bindebende/PowerUART/README.md

# PowerUART
Under Development!!!
USB to UART converter with Type C connector and 100W Power Delivery

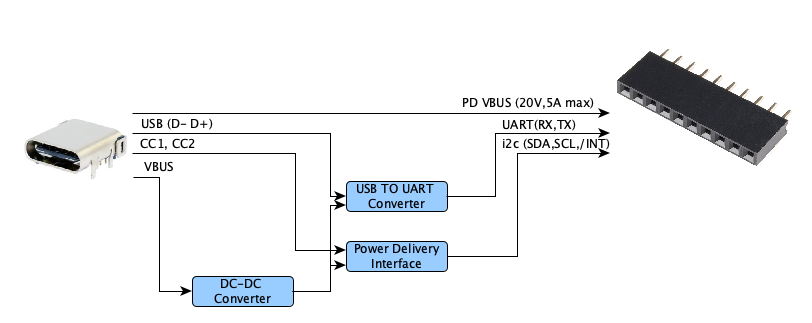
[picture p1: Design/HLD.png]
High Level Design
