bindebende/PowerUART/Design/source/BOM.xlsx

Function | Links | Price( min 100 pcs) | Extended price
PD interface | FUSB302BMPX (https://hu.mouser.com/ProductDetail/ON-Semiconductor-Fairchild/FUSB302BMPX) | 308.36 Ft | 30836.00 Ft
usb interface | CP2102N (https://hu.mouser.com/ProductDetail/Silicon-Labs/CP2102N-A01-GQFN24) | 402.21 Ft | 40221.00 Ft
usb con | usb type c con. Female (https://hu.mouser.com/ProductDetail/Amphenol-Commercial-Products/12401598E42A) | 389.31 Ft | 38931.00 Ft
tvs | ESD TVS (https://hu.mouser.com/ProductDetail/STMicroelectronics/ESDCAN24-2BLY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) | 44.47 Ft | 13341.00 Ft
LED | LED (https://hu.mouser.com/ProductDetail/Wurth-Electronics/150080GS75000) | 40.22 Ft | 16088.00 Ft
Supply | TPS57160QDRCRQ1 (https://hu.mouser.com/ProductDetail/Texas-Instruments/TPS57160QDRCRQ1) | 850.20 Ft | 85020.00 Ft
Input capacitor 2.2uF | Input capacitor 2.2uF (https://hu.mouser.com/ProductDetail/KEMET/C1206C225K3REC7210) | 20.93 Ft | 2093.00 Ft
Input capacitor 100nF | Input Capacitor 100nF (https://hu.mouser.com/ProductDetail/Murata-Electronics/GCM155R71H104ME02D) | 8.18 Ft | 818.00 Ft
Inductor | Inductor (https://hu.mouser.com/ProductDetail/Bourns/SRN6045TA-100M) | 68.67 Ft | 6867.00 Ft
output Cap | Output capacitor (https://hu.mouser.com/ProductDetail/AVX/TCJA476M006R0070) | 103.66 Ft | 10366.00 Ft
Diode | Diode (https://hu.mouser.com/ProductDetail/Vishay-Semiconductors/B240A-E3-5AT) | 52.32 Ft | 5232.00 Ft
SS/TR Cap 0.01uF | SS/TR cap 0.01uF (https://hu.mouser.com/ProductDetail/Murata-Electronics/GCM155R71E103JA37D) | 5.56 Ft | 556.00 Ft
CLK 90.9k | CLK resistor 90.9k (https://hu.mouser.com/ProductDetail/Yageo/RC0402FR-0790K9L?qs=sGAEpiMZZMtlubZbdhIBIDGYITUTlqW8U2zx0aAOop8%3d) | 0.98 Ft | 98.00 Ft
COMP 6.8pF | COMP 6.8pF (https://hu.mouser.com/ProductDetail/Wurth-Electronics/885012005054) | 3.92 Ft | 392.00 Ft
Comp 2.7nF | COMP 2.7nF (https://hu.mouser.com/ProductDetail/Yageo/CC0402KRX7R8BB272) | 3.27 Ft | 327.00 Ft
COMP 76.8k | COMP 76.8k (https://hu.mouser.com/ProductDetail/Yageo/RC0402FR-0776K8L?qs=sGAEpiMZZMvdGkrng054t8AJgcdMkx7xWtIAm8qlIKw%3d) | 0.98 Ft | 98.00 Ft
FB 52.5K | FB 52.5k (https://hu.mouser.com/ProductDetail/Yageo/RC0402FR-0752K3L?qs=sGAEpiMZZMvdGkrng054t8AJgcdMkx7xvsgsl41vLTs%3d) | 0.98 Ft | 98.00 Ft
FB 10K | FB 10k (https://hu.mouser.com/ProductDetail/Yageo/RC0402FR-0710KL?qs=sGAEpiMZZMvdGkrng054txdMlaQGj9fiev8zvarNyCY%3d) | 0.98 Ft | 98.00 Ft
PCB (100*100, 3 design/ panel, 2layer, bilind via) |  | 348.77 Ft | 19624.00 Ft
VAT+shipping |  | 825.83 Ft | 82582.74 Ft
SUM (HUF) |  | 3479.80 Ft | 353686.74 Ft
SUM (USD) |  | 12.23 USD | 1242.86 USD
Recomended selling price(USD) |  | 35.00 USD | 3500.00 USD
Margin(USD) |  | 22.77 USD | 2257.14 USD
Margin(HUF) |  | 6476.68 Ft | 641963.82 Ft
