bindebende/PowerUART/HW/Schematic/Outputs/PowerUART_schematic.pdf

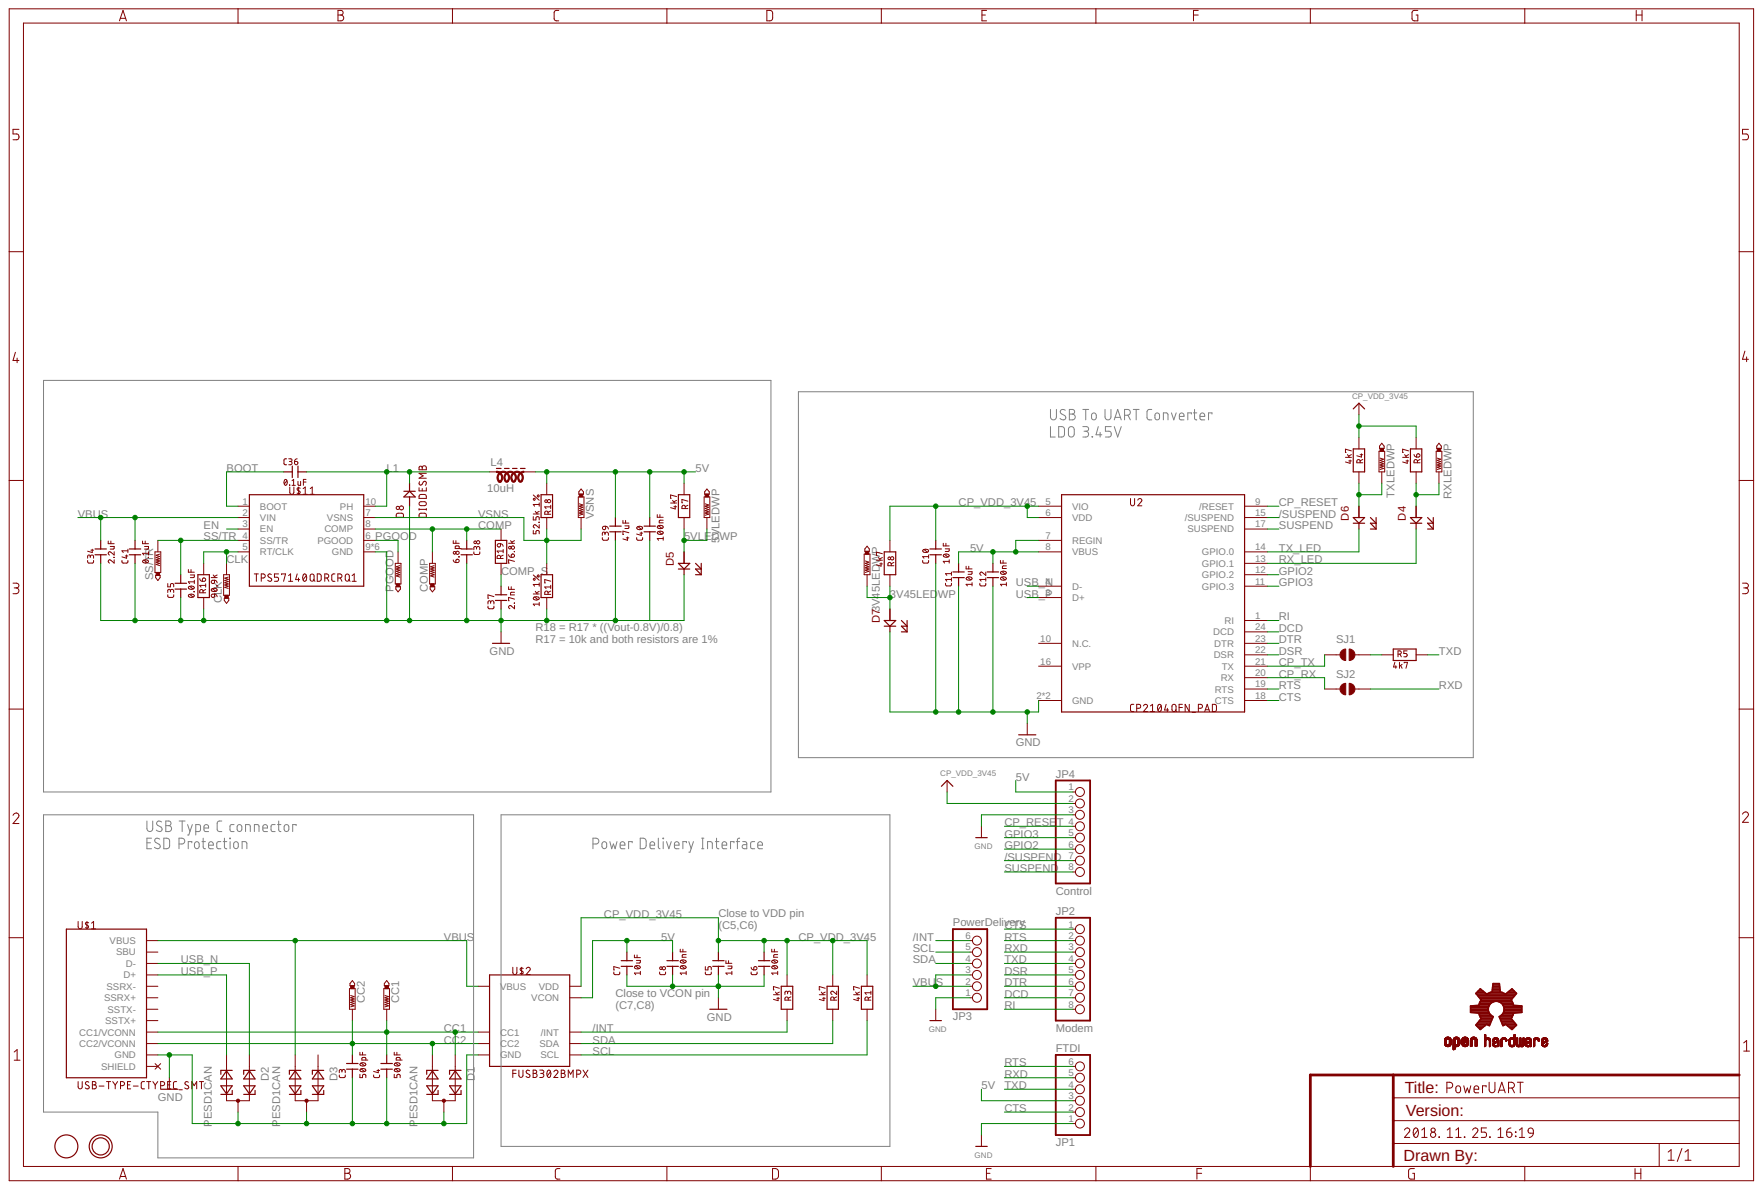
[picture p2: page 1]

D6 D4 Drawn By: Title: Version:

R18 = R17 * ((Vout-0.8V)/0.8) R17 = 10k and both resistors are 1%

CP_VDD_3V45
(C5,C6) Close to VCON pin
SCL SDA

Close to VDD pin
