bindebende/PowerUART/Design/HLD.pdf

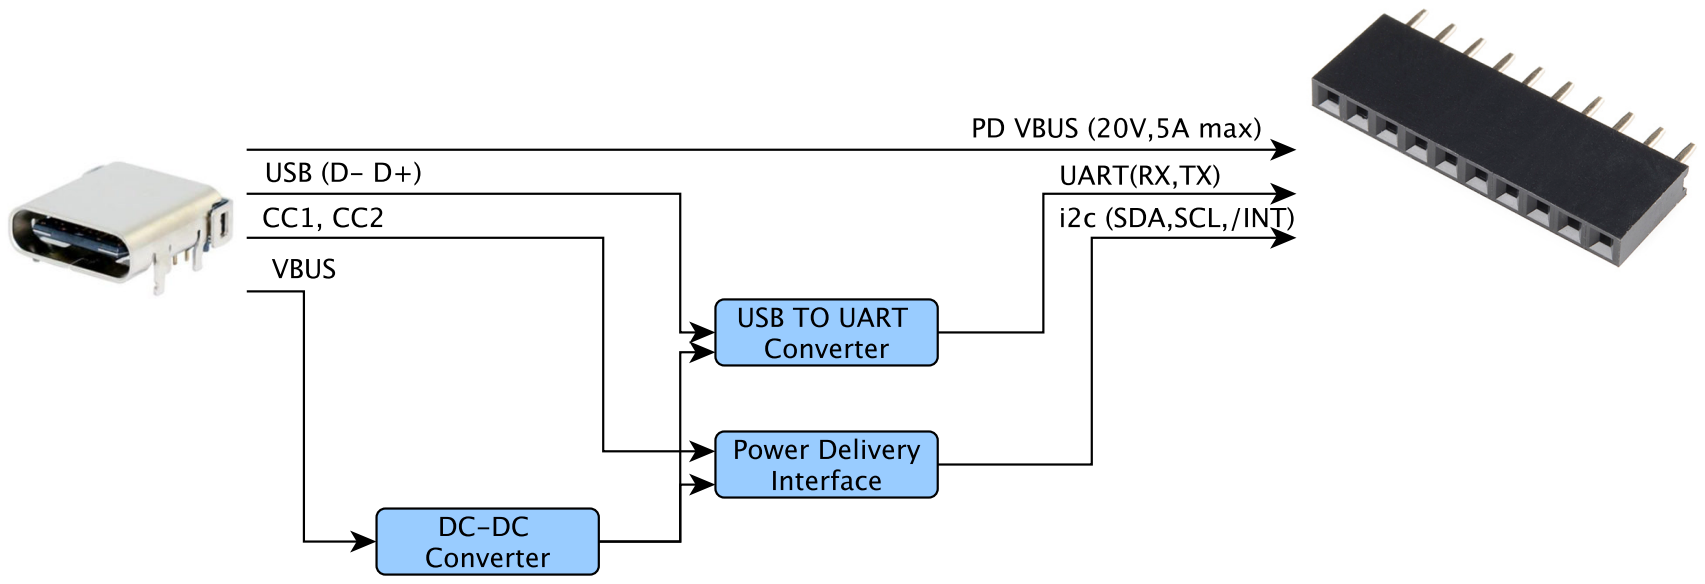
[picture p3: page 1]
