bindebende/PowerUART/HW/Schematic/Outputs/PowerUART_layout_BOT.pdf

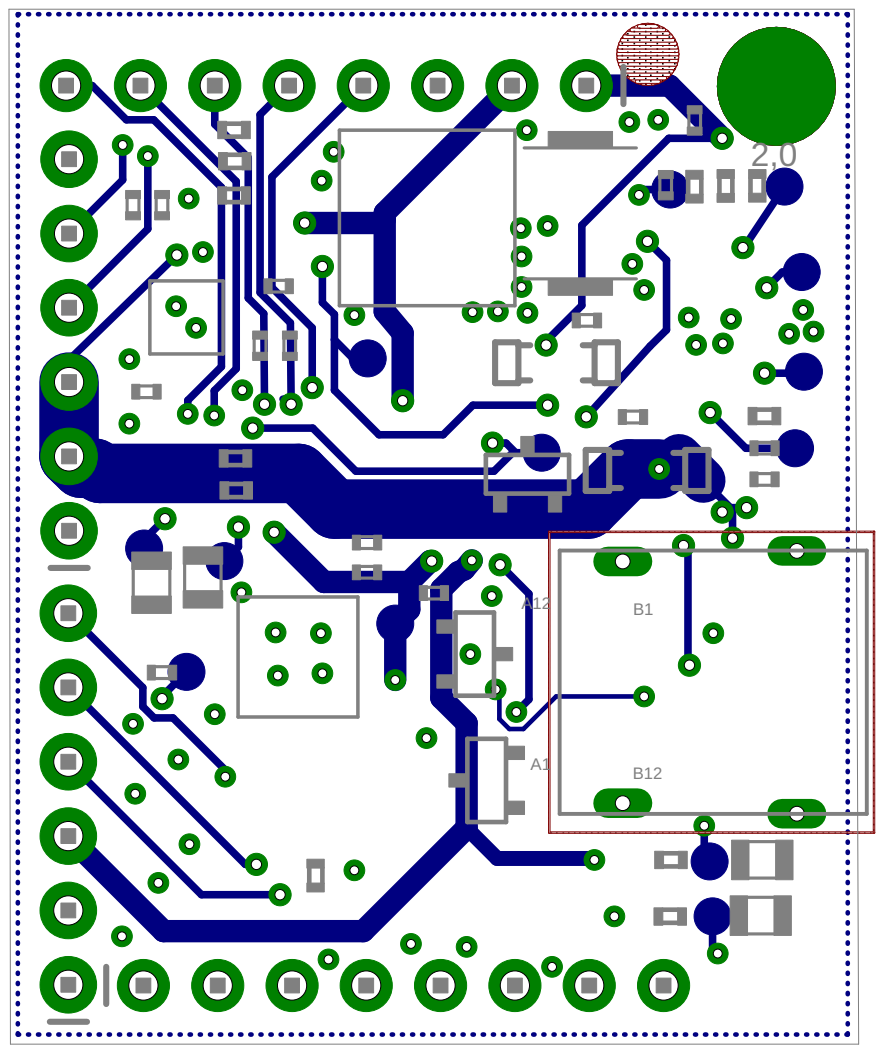
[picture p4: page 1]
