bindebende/PowerUART/HW/Schematic/Outputs/PowerUART_layout_TOP.pdf

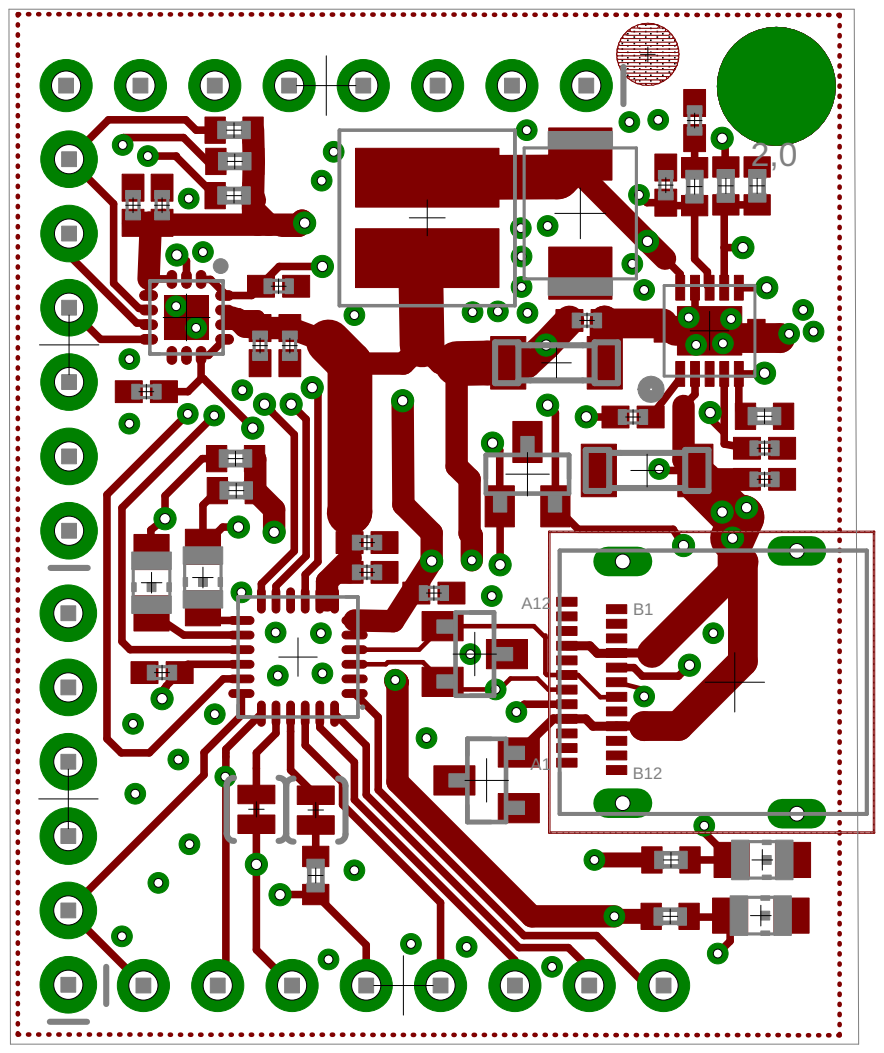
[picture p5: page 1]
