bindebende/PowerUART/HW/Schematic/PowerUART.brd

## EAGLE design HW/Schematic/PowerUART.brd (2018-11-25)

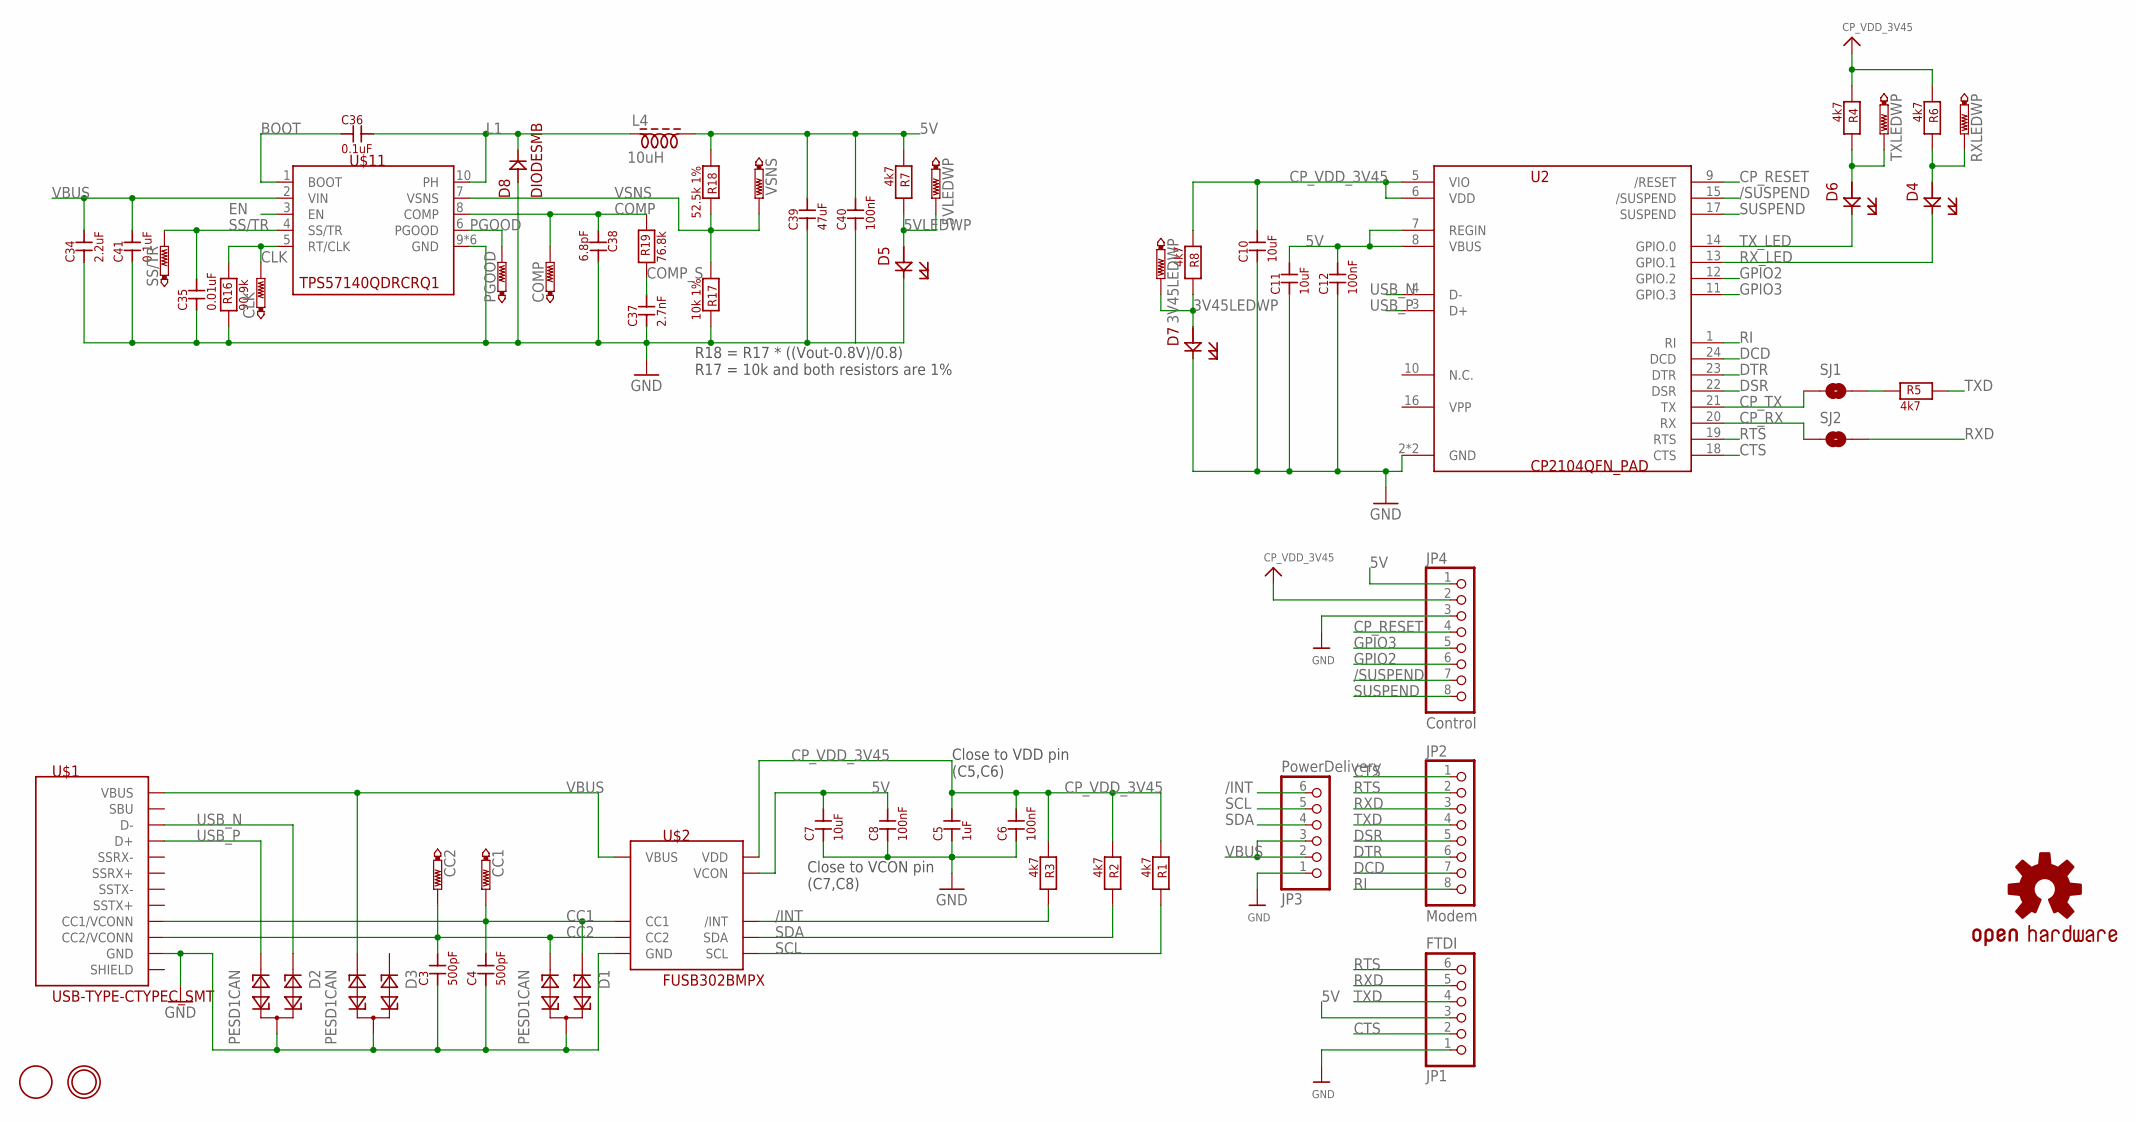
[picture p6: schematic PowerUART.sch]

Parts:
3V45LEDWP, 5VLEDWP: CP_RESET; B1,27
C3, C4: 500pF; C0402K
C5: 1uF; C0402K
C6, C8, C12, C40: 100nF; C0402K
C7, C10, C11: 10uF; C0402K
C34: 2.2uF; SM-1206
C35: 0.01uF; C0402K
C36, C41: 0.1uF; C0402K
C37: 2.7nF; C0402K
C38: 6.8pF; C0402K
C39: 47uF; SM-1206
CC1, CC2: CP_RESET; B1,27
CLK: CP_RESET; B1,27
COMP: CP_RESET; B1,27
D1, D2, D3: PESD1CAN; SOT23
D4, D5, D6, D7: LED; CHIP-LED0805
D8: DIODESMB; SMBJ
GND: MOUNTINGHOLE2.0; MOUNTINGHOLE_2.0_PLATED
JP1: FTDI; 1X06_ROUND_76
JP2: Modem; 1X08_ROUND_70
JP3: PowerDelivery; 1X06_ROUND_76
JP4: Control; 1X08_ROUND_70
L4: 10uH; DFN600X600X420-2
LOGO1: OSHW-LOGOMINI; OSHW-LOGO-MINI
PGOOD: CP_RESET; B1,27
R1, R2, R3, R4, R5, R6, R7, R8: 4k7; R0402
R16: 90.9k; R0402
R17: 10k 1%; R0402
R18: 52.5k 1%; R0402
R19: 76.8k; R0402
RXLEDWP: CP_RESET; B1,27
SJ1, SJ2: SOLDERJUMPER-OLDTRACE; SJ_2S-TRACE
SS/TR: CP_RESET; B1,27
TP2: FIDUCIAL; FIDUCIAL_1MM
TXLEDWP: CP_RESET; B1,27
U2: CP2104QFN_PAD; QFN50P400X400X80-25T245
U$1: USB-TYPE-CTYPEC_SMT; TYPECSMT
U$2: FUSB302BMPX; QFN50P250X250X80-15T150
U$11: TPS57140QDRCRQ1; VSON10
VSNS: CP_RESET; B1,27

Connections:
3V45LEDWP: 3V45LEDWP.TP, D7.A (_), R8.2 (__)
5V: C7.2 (__), C8.2 (__), C11.2 (__), C12.2 (__), C39.2 (__), C40.2 (__), JP1.3, JP4.1, L4.2, R7.1 (_), R18.1 (_), U2.7 (REGIN), U2.8 (VBUS), U$2.12 (VCON), U$2.13 (VCON)
5VLEDWP: 5VLEDWP.TP, D5.A (_), R7.2 (__)
/INT: JP3.6, R3.2 (__), U$2.5 (/INT)
/SUSPEND: JP4.7, U2.15 (/SUSPEND)
BOOT: C36.1 (_), U$11.1 (BOOT)
CC1: C4.2 (__), CC1.TP, D1.1, U$1.A5 (CC1/VCONN), U$2.10 (CC1), U$2.11 (CC1)
CC2: C3.2 (__), CC2.TP, D1.2, U$1.B5 (CC2/VCONN), U$2.1 (CC2), U$2.14 (CC2)
CLK: CLK.TP, R16.2 (__), U$11.5 (RT/CLK)
COMP: C38.1 (_), COMP.TP, R19.2 (__), U$11.8 (COMP)
COMP_S: C37.2 (__), R19.1 (_)
CP_RESET: JP4.4, U2.9 (/RESET)
CP_RX: SJ2.1, U2.20 (RX)
CP_TX: SJ1.1, U2.21 (TX)
CP_VDD_3V45: C5.2 (__), C6.2 (__), C10.2 (__), JP4.2, R1.1 (_), R2.1 (_), R3.1 (_), R4.1 (_), R6.1 (_), R8.1 (_), U2.5 (VIO), U2.6 (VDD), U$2.3 (VDD), U$2.4 (VDD)
CTS: JP1.2, JP2.1, U2.18 (CTS)
DCD: JP2.7, U2.24 (DCD)
DSR: JP2.5, U2.22 (DSR)
DTR: JP2.6, U2.23 (DTR)
EN: U$11.3 (EN)
GND: C3.1 (_), C4.1 (_), C5.1 (_), C6.1 (_), C7.1 (_), C8.1 (_), C10.1 (_), C11.1 (_), C12.1 (_), C34.1 (_), C35.1 (_), C37.1 (_), C38.2 (__), C39.1 (_), C40.1 (_), C41.1 (_), D1.3, D2.3, D3.3, D5.C (__), D7.C (__), D8.A, JP1.1, JP3.1, JP4.3, R16.1 (_), R17.2 (__), U2.2 (GND), U2.25 (GND), U$1.A1 (GND), U$1.A12 (GND), U$1.B1 (GND), U$1.B12 (GND), U$2.8 (GND), U$2.9 (GND), U$2.15 (GND), U$11.9 (GND), U$11.11 (GND), U$11.12 (GND), U$11.13 (GND), U$11.14 (GND), U$11.15 (GND)
GPIO2: JP4.6, U2.12 (GPIO.2)
GPIO3: JP4.5, U2.11 (GPIO.3)
L1: C36.2 (__), D8.C, L4.1, U$11.10 (PH)
unnamed: R5.1 (_), SJ1.2
PGOOD: PGOOD.TP, U$11.6 (PGOOD)
RI: JP2.8, U2.1 (RI)
RTS: JP1.6, JP2.2, U2.19 (RTS)
RXD: JP1.5, JP2.3, SJ2.2
RXLEDWP: D4.A (_), R6.2 (__), RXLEDWP.TP
RX_LED: D4.C (__), U2.13 (GPIO.1)
SCL: JP3.5, R1.2 (__), U$2.6 (SCL)
SDA: JP3.4, R2.2 (__), U$2.7 (SDA)
SS/TR: C35.2 (__), SS/TR.TP, U$11.4 (SS/TR)
SUSPEND: JP4.8, U2.17 (SUSPEND)
TXD: JP1.4, JP2.4, R5.2 (__)
TXLEDWP: D6.A (_), R4.2 (__), TXLEDWP.TP
TX_LED: D6.C (__), U2.14 (GPIO.0)
USB_N: D2.1, U2.4 (D-), U$1.A7 (D-), U$1.B7 (D-)
USB_P: D2.2, U2.3 (D+), U$1.A6 (D+), U$1.B6 (D+)
VBUS: C34.2 (__), C41.2 (__), D3.2, JP3.2, JP3.3, U$1.A4 (VBUS), U$1.A9 (VBUS), U$1.B4 (VBUS), U$1.B9 (VBUS), U$2.2 (VBUS), U$11.2 (VIN)
VSNS: R17.1 (_), R18.2 (__), U$11.7 (VSNS), VSNS.TP

Notes on the sheet:
Close to VDD pin (C5,C6)
Close to VCON pin (C7,C8)
R18 = R17 * ((Vout-0.8V)/0.8) R17 = 10k and both resistors are 1%

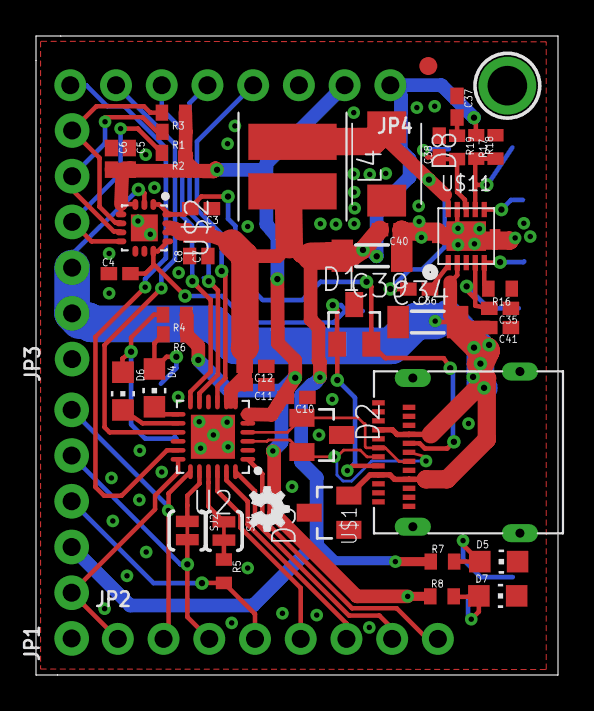
[picture p7: board PowerUART.brd from above]

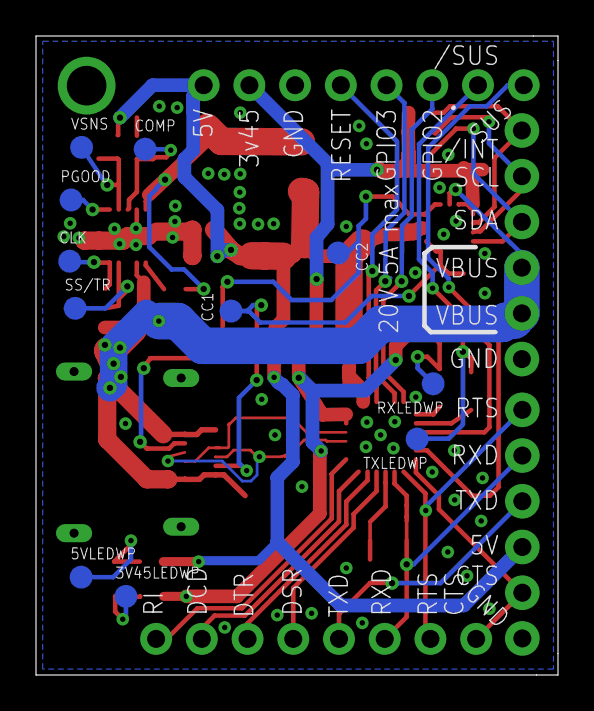
[picture p8: board PowerUART.brd from below]

Board: 2 copper layers, 29.0 x 35.5 mm, 62 parts (11 on the bottom side), 41 nets.
