bindebende/PowerUART/(threads)

Thread 1 (2018-11-14):

USB type c to uart converter

bindebende, 2018-11-14:
https://www.digikey.com/en/articles/techzone/2017/mar/designing-in-usb-type-c-and-using-power-delivery-for-rapid-charging

* Breadboard friendly
* Power delivery? FUSB302, STUSB1600

Thread 2 (2018-11-15):

Schematic fixes

bindebende, 2018-11-15:
- [ ] Same LED
- [ ] USB signals are not connected
- [ ] CP_Reset and "Control" header is not connected

Thread 5 (2018-11-17):

Create USB type C connector library

bindebende, 2018-11-17:

bindebende, 2018-11-17:
Done from snapeda

Closed 2018-11-17.

Thread 6 (2018-11-17):

Layout checklist

bindebende, 2018-11-17:
TPS55165:
- [ ] Place decoupling capacitors as close as possible to the input
- [ ] Make the power flow in a straight path rather than a zigzag path on the board.
- [ ] Use the PGND pin, GND pin, and the device PowerPAD as the single-point connection between the analog and power grounds
- [ ] Use eight to nine via holes with a 0.3 mm diameter in the device PowerPAD to help dissipate heat through
- [ ] Use at least ten via holes with a 0.3 mm diameter around the input and output capacitors that are connected to ground-plane layers to minimize the PCB impedance for power current flows

Closed 2018-11-24.

Thread 8 (2018-11-19):

Voltage regulator

bindebende, 2018-11-19:
* TPS57140-q1 or equivalent (Buck converter 1.5A 5V out 100% PWM Duty Cycle)
 * [TPS57140](https://hu.mouser.com/ProductDetail/Texas-Instruments/TPS57140QDRCRQ1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): 889.44 HUF
 * [TPS57160QDRCRQ1](https://hu.mouser.com/ProductDetail/Texas-Instruments/TPS57160QDRCRQ1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): 1157.58HUF

  * [Input capacitor 2.2uF](https://hu.mouser.com/ProductDetail/KEMET/C1206C225M5RECTU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): 59.84 HUF
  * [Input Capacitor 100nF](https://hu.mouser.com/ProductDetail/Murata-Electronics/GCM155L81E104KE02D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): 31.39 HUF
  * [Inductor](https://hu.mouser.com/ProductDetail/Bourns/SRN6045TA-100M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): 108.56 HUF
  * [Output capacitor](https://hu.mouser.com/ProductDetail/AVX/TCJA476M006R0070?qs=sGAEpiMZZMsh%252b1woXyUXj0IR3cqcSLXPgS6Vfb7m64Q%3d): 222.69 HUF
  * [Diode](https://hu.mouser.com/ProductDetail/Vishay-Semiconductors/B240A-E3-5AT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): 114 HUF
worst case price: 1668.67 HUF or 5.95 USD

bindebende, 2018-11-20:
diode change: [Diode](https://hu.mouser.com/ProductDetail/Vishay-Semiconductors/B240A-E3-5AT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): 114 HUF

bindebende, 2018-11-23:
merged into the main issue

Closed 2018-11-23.

Thread 12 (2018-11-20):

End Of Line Tests

bindebende, 2018-11-20:
Short test to GND:
 * 5V, VBUS, 3v45

USB converter:
 * measure 3V45

PD Indterface:
 * Pullup measurement
  * SDA, SCL, /INT
 * Check ID register
 * Get different VBUS voltages (5V, 12V, 20V)
  * measure VBUS
PMIC:
 * Step through possible input voltages (5V, 12V, 20V)
  * measure output voltage
 * Feedback voltage measurement
 * Load test of 1A
  * measure output voltage and current
 * Short to GND test
  * measure output voltage and current
