bindebende/PowerUART/(commit log)

2018-11-14 Base schematic
    Add: - Base schematic
    - Datasheets
    [TypeCConverter.sch]
2018-11-14 generate schematic pdf
2018-11-17 Add TPS55165
    Add TPS55165 and it’s circuitry
    layout file is created
    [TypeCConverter.brd, TypeCConverter.sch]
2018-11-17 Add high level design regenerate schematic pdf
2018-11-20 Finish pre layout
    Generate layout pdfs
    [TypeCConverter.brd, TypeCConverter.sch]
2018-11-23 Add BOM
    [BOM.xlsx, TypeCConverter.brd, TypeCConverter.sch]
2018-11-24 rename files according to the new project name
    [PowerUART.brd, PowerUART.sch]
2018-11-24 Update BOM
    [BOM.xlsx]
2018-11-24 Add labels
    [PowerUART.brd, PowerUART.sch]
2018-11-25 add testpoints.csv
    [PowerUART.brd, PowerUART.sch, testpoints.csv]
2018-11-25 csv formatting testpoint.csv
    [testpoints.csv]
2018-11-25 Add silta based EOL Tests
    [PowerUART.brd]
